mduomarco-sketch/drip-tray/STEP/drip_tray_full_reference.step

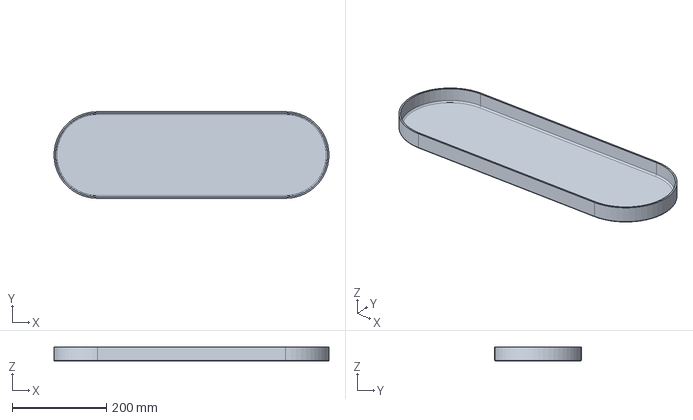
[picture p8: CAD file, 2026-10-13]
STEP/drip_tray_full_reference.step
584.0 x 184.0 x 30.0 mm
