mduomarco-sketch/drip-tray/slice/A/drip_tray_part_A.gcode.3mf

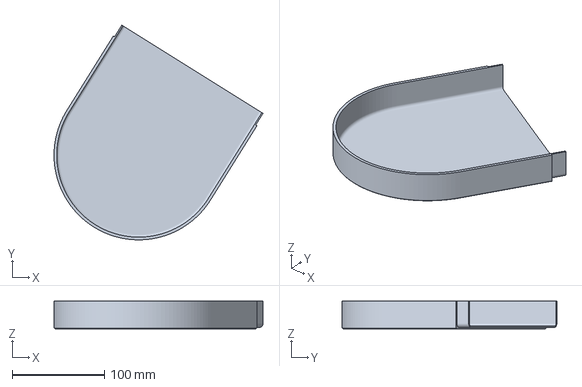
[picture p9: CAD file, 2026-10-13]
slice/A/drip_tray_part_A.gcode.3mf
227.0 x 233.3 x 30.0 mm
