mduomarco-sketch/drip-tray/slice/B/drip_tray_part_B.gcode.3mf

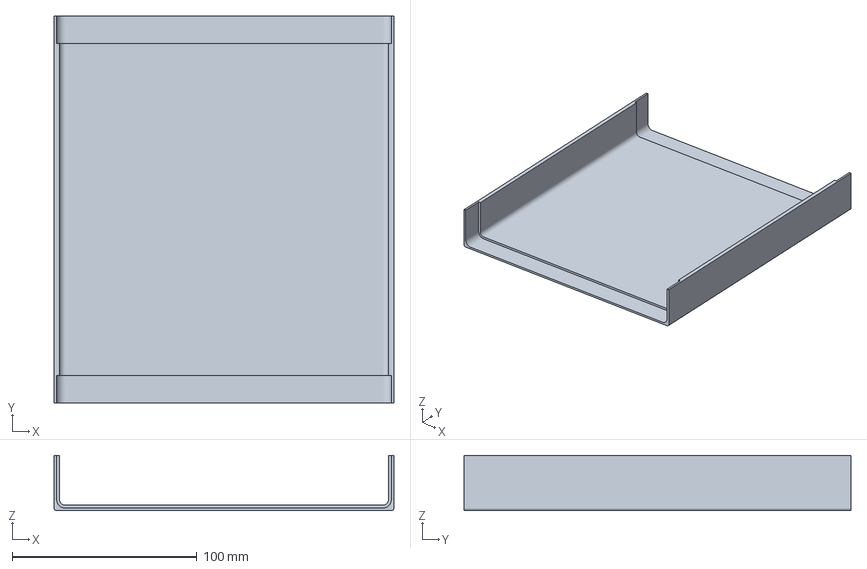
[picture p10: CAD file, 2026-10-13]
slice/B/drip_tray_part_B.gcode.3mf
184.0 x 209.5 x 30.0 mm
