mduomarco-sketch/drip-tray/STEP/drip_tray_exploded.step

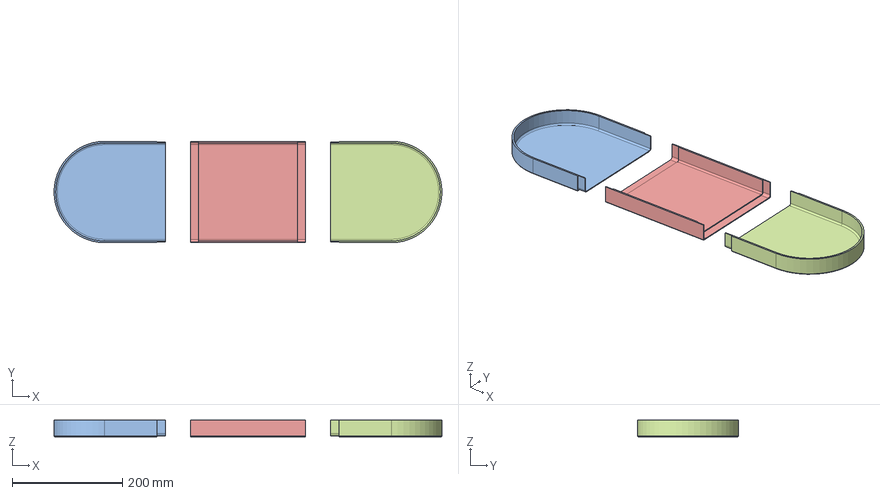
[picture p11: CAD file, 2026-10-13]
STEP/drip_tray_exploded.step
704.0 x 184.0 x 30.0 mm
part_A
part_B
part_C
