mduomarco-sketch/drip-tray/STEP/drip_tray_part_C.step

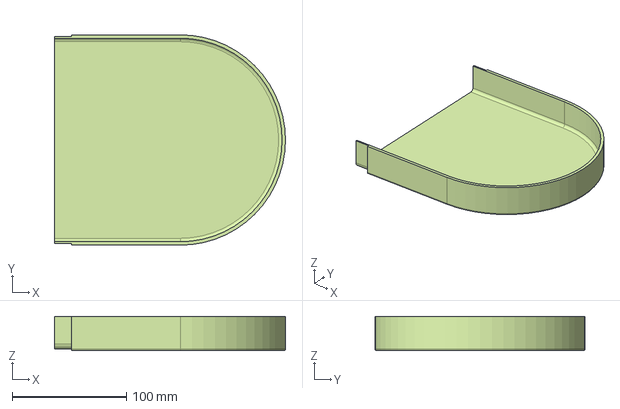
[picture p12: CAD file, 2026-10-13]
STEP/drip_tray_part_C.step
202.1 x 184.0 x 30.0 mm
