mduomarco-sketch/drip-tray/(list of files, cad)

Other CAD files:
slice/C/drip_tray_part_C.gcode.3mf
STEP/drip_tray_part_B.step
STEP/drip_tray_part_A.step
STL/drip_tray_full_reference.stl
STL/drip_tray_part_A.stl
STL/drip_tray_part_B.stl
STL/drip_tray_part_C.3mf
STL/drip_tray_part_C.stl
