mduomarco-sketch/drip-tray/(commit log)

2026-10-13 Bandeja a medida para cesta de forja: modelo, piezas para imprimir y README del proceso
    [drip_tray_assembly.step, drip_tray_exploded.step, drip_tray_full_reference.step, drip_tray_full_reference.stl, drip_tray_part_A.gcode.3mf, drip_tray_part_A.step, drip_tray_part_A.stl, drip_tray_part_B.gcode.3mf]
2026-10-13 README: la foto 3 muestra la jardinera
